Nitrokey/nitrokey-3c-nfc-lpc55-hardware/production-data/nk3cn424-zeus-assembled.png

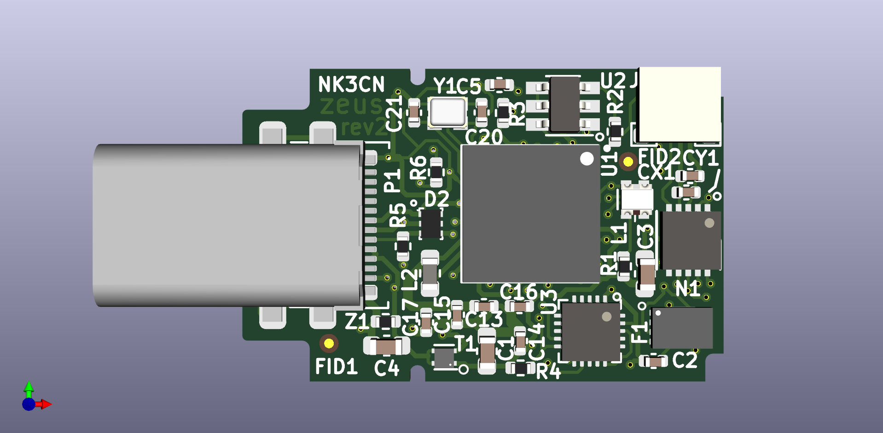
production-data/nk3cn424-zeus-assembled.png
