Nitrokey/nitrokey-3c-nfc-lpc55-hardware/production-data/USB_plug_pins.png

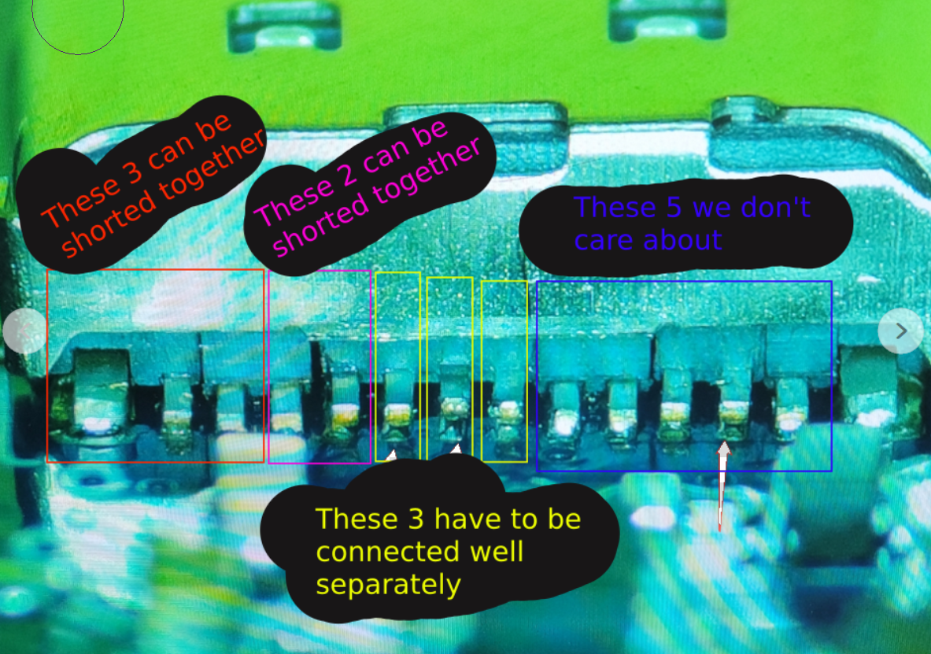
production-data/USB_plug_pins.png
