Nitrokey/nitrokey-3c-nfc-lpc55-hardware/README.md

# Nitrokey 3C NFC Hardware

The hardware files of [Nitrokey 3C NFC](https://shop.nitrokey.com/shop/nk3cn-nitrokey-3c-nfc-148).
The firmware is [here](https://github.com/Nitrokey/nitrokey-3-firmware).
