Nitrokey/nitrokey-3c-nfc-lpc55-hardware/nk3cn-zeus.step

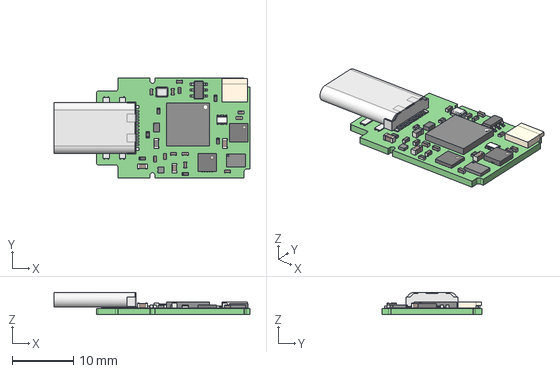
[picture p3: CAD file, 2026-04-24]
nk3cn-zeus.step
31.9 x 16.2 x 3.60 mm
