Nitrokey/nitrokey-3c-nfc-lpc55-hardware/nk3cn-zeus.pdf

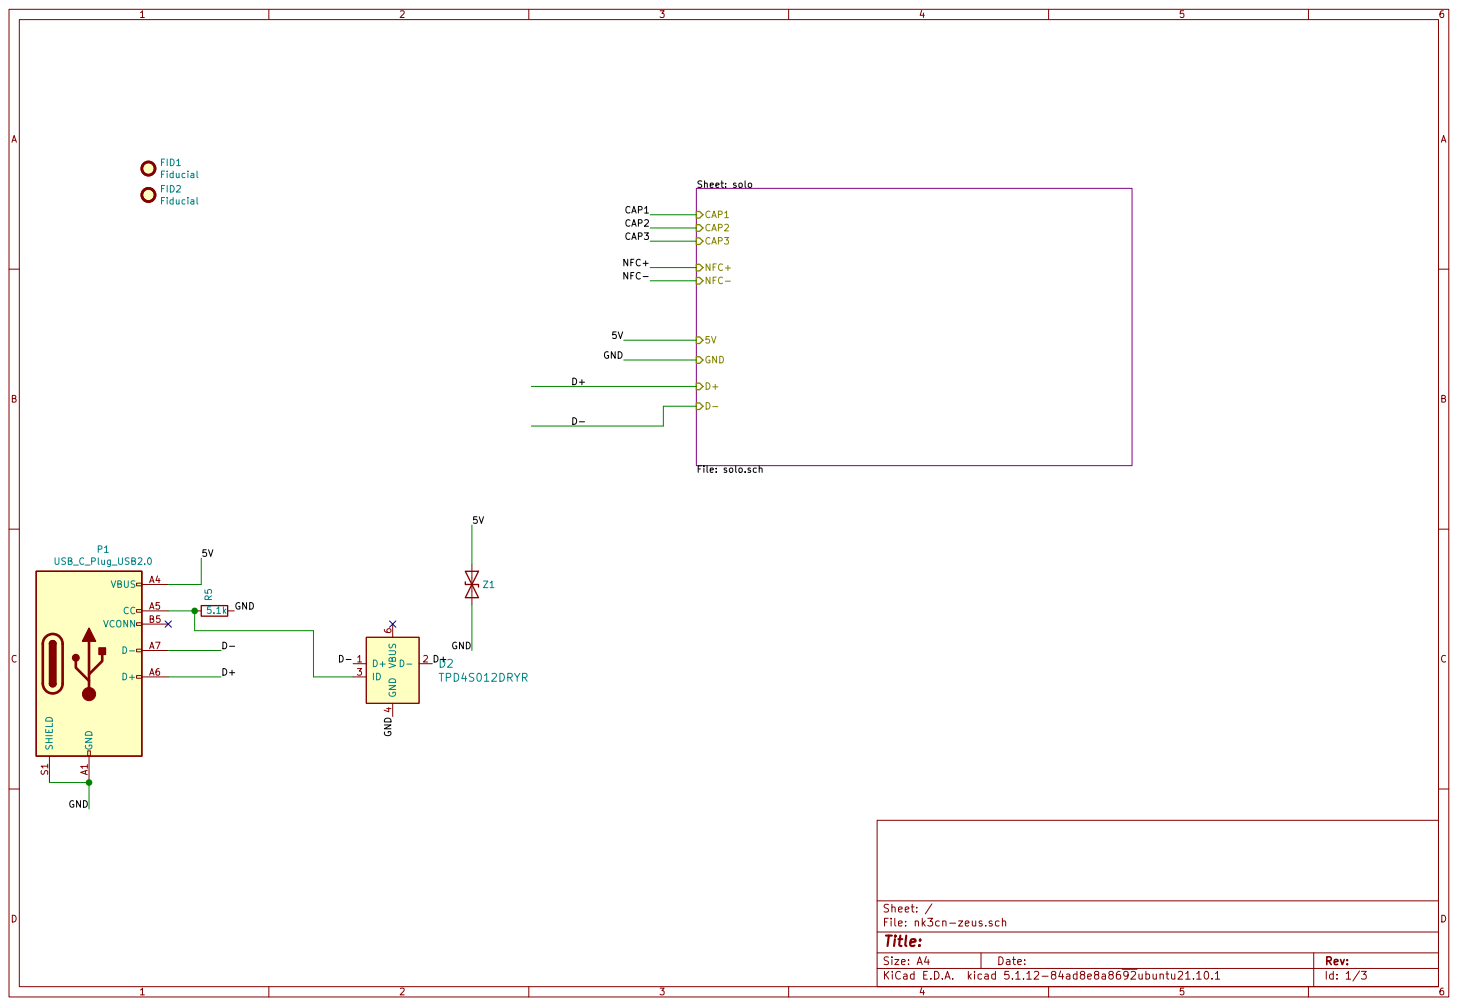
[picture p4: page 1]

Sheet: solo File: solo.sch
CAP1 CAP2 CAP3 NFC+

Id: 1/3 Title: File: nk3cn-zeus.sch Sheet: /

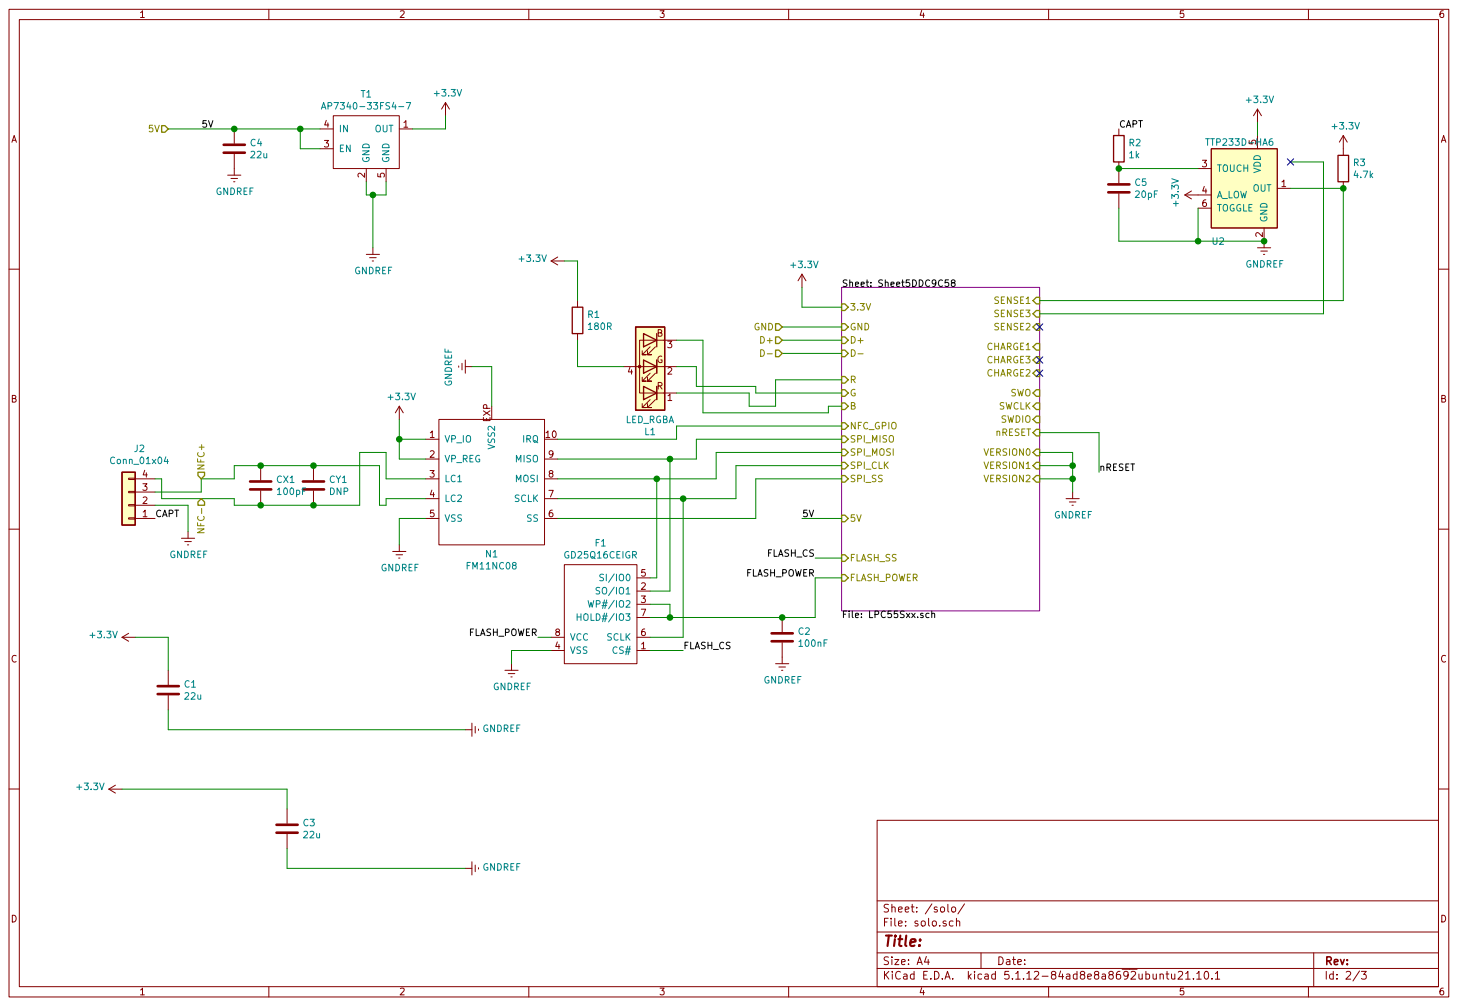
[picture p5: page 2]

Id: 2/3 Title: File: solo.sch Sheet: /solo/

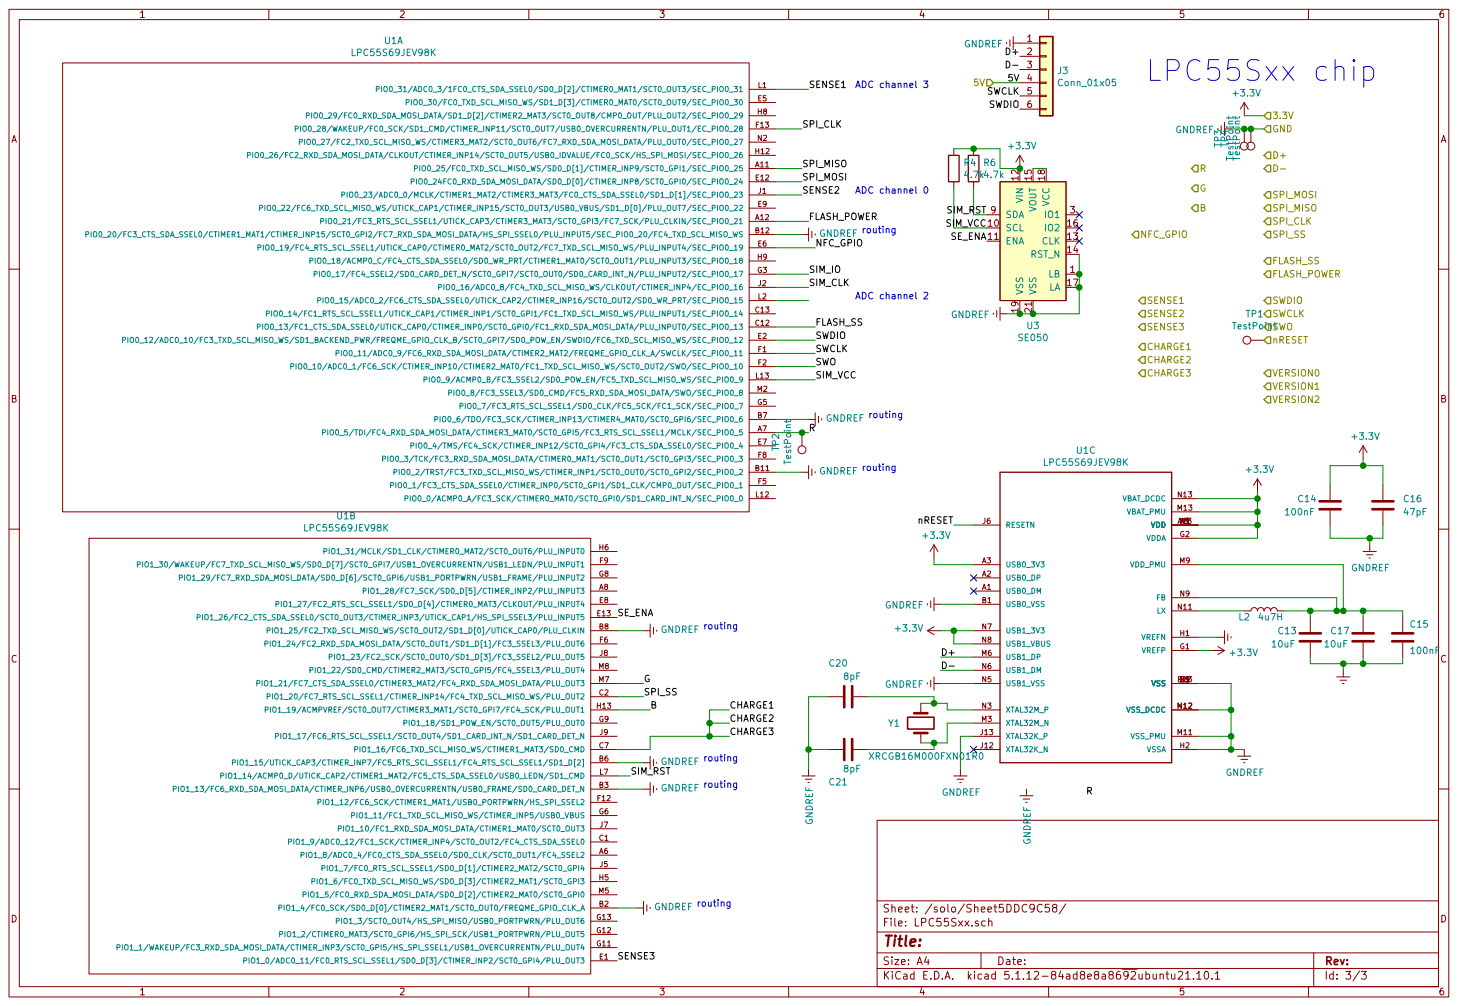
[picture p6: page 3]

ADC channel 0 ADC channel 3

Id: 3/3 Title: File: LPC55Sxx.sch Sheet: /solo/Sheet5DDC9C58/
