Nitrokey/nitrokey-3c-nfc-lpc55-hardware/nk3cn-zeus.kicad_pcb

## KiCad design nk3cn-zeus.kicad_pcb (2026-04-24)

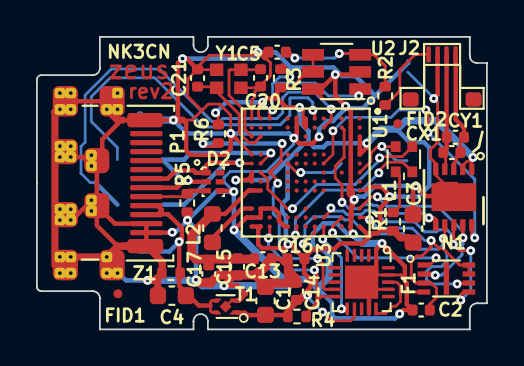
[picture p7: board nk3cn-zeus.kicad_pcb from above]

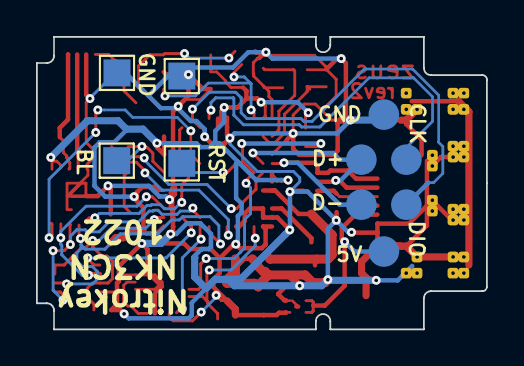
[picture p8: board nk3cn-zeus.kicad_pcb from below]

Board: 2 copper layers, 25.0 x 16.2 mm, 40 parts (5 on the bottom side), 33 nets.

Parts:
C1, C3, C4: 22u; C_0603_1608Metric
C2, C14, C15: 100nF; C_0402_1005Metric
C5: 20pF; C_0402_1005Metric
C13, C17: 10uF; C_0402_1005Metric
C16: 47pF; C_0402_1005Metric
C20, C21: 8pF; C_0402_1005Metric
CX1: 100pF; C_0402_1005Metric
CY1: DNP; C_0402_1005Metric
D2: TPD4S012DRYR; UFDFN-6_1.45x1mm
F1: GD25Q16CEIGR; FLASH_2x3_USON8
FID1, FID2: Fiducial; Fiducial_0.5mm_Mask1mm
J2: Conn_01x04; FPC_4_0.5-THD0509-04CL-GF
J3: Conn_01x05; nitro_programming_header
L1: LED_RGBA; RGB_LED_606
L2: 4u7H; L_0603_1608Metric
N1: FM11NC08; DFN-10-1EP_3x3mm_P0.5mm_EP1.55x2.48mm
P1: USB_C_Plug_USB2.0; UTC009-C-vias-optimized
R1: 180R; R_0402_1005Metric
R2: 1k; R_0402_1005Metric
R3, R4, R6: 4.7k; R_0402_1005Metric
R5: 5.1k; R_0402_1005Metric
T1: AP7340-33FS4-7; Diodes_X2-DFN1010_1x1mm_P0.65mm
TP1, TP2, TP3, TP4: TestPoint; TestPoint_Pad_1.5x1.5mm
U1: LPC55S69JEV98K; BGA98C50P13X13_700X700X97N
U2: TTP233D-HA6; TSOT-23-6
U3: SE050; UQFN-20-1EP_3x3mm_P0.4mm_EP1.85x1.85mm
Y1: XRCGB16M000FXN01R0; Crystal-2mmx1.6mm
Z1: GG040205100N2P; R_0402_1005Metric

Connections:
+3V3: C1.1, C3.1, C14.1, C16.1, N1.1, N1.2, R1.1, R3.1, R4.1, R6.1, T1.1, U1.A3, U1.A5, U1.A9, U1.A13, U1.G1, U1.G2, U1.M1, U1.M13, U1.N7, U1.N8, U1.N13, U2.4, U2.5, U3.12
/5V: C4.1, J3.4, P1.A4, P1.B9, T1.3, T1.4, Z1.1
/D+: D2.2, J3.2, P1.A6, U1.M6
/D-: D2.1, J3.3, P1.A7, U1.N6
/NFC+: CX1.1, CY1.1, J2.3, N1.4
/NFC-: CX1.2, CY1.2, J2.4, N1.3
/solo/CAPT: J2.1, R2.1
/solo/FLASH_CS: F1.1, U1.C12
/solo/FLASH_POWER: C2.1, F1.3, F1.7, F1.8, U1.A12
/solo/Sheet5DDC9C58/B: L1.3, U1.H13
/solo/Sheet5DDC9C58/G: L1.2, U1.M7
/solo/Sheet5DDC9C58/NFC_GPIO: N1.10, U1.E6
/solo/Sheet5DDC9C58/R: L1.1, TP2.1, U1.A7
/solo/Sheet5DDC9C58/SENSE1: R3.2, U1.L1, U2.1
/solo/Sheet5DDC9C58/SE_ENA: U1.E13, U3.11
/solo/Sheet5DDC9C58/SIM_RST: R6.2, U1.L7, U3.9
/solo/Sheet5DDC9C58/SIM_VCC: R4.2, U1.L13, U3.10
/solo/Sheet5DDC9C58/SPI_CLK: F1.6, N1.7, U1.F13
/solo/Sheet5DDC9C58/SPI_MISO: F1.2, N1.9, U1.A11
/solo/Sheet5DDC9C58/SPI_MOSI: F1.5, N1.8, U1.E12
/solo/Sheet5DDC9C58/SPI_SS: N1.6, U1.C2
/solo/Sheet5DDC9C58/SWCLK: J3.5, U1.F1
/solo/Sheet5DDC9C58/SWDIO: J3.6, U1.E2
/solo/nRESET: TP1.1, U1.J6
GNDREF: C1.2, C2.2, C3.2, C4.2, C5.2, C13.2, C14.2, C15.2, C16.2, C17.2, C20.1, C21.1, D2.4, F1.4, J2.2, J3.1, N1.5, N1.EXP, P1.A1, P1.B12, P1.S1, R5.2, T1.2, T1.5, TP3.1, TP4.1, U1.B1, U1.B2, U1.B3, U1.B5, U1.B6, U1.B7, U1.B8, U1.B9, U1.B11, U1.B12, U1.B13, U1.H1, U1.H2, U1.J13, U1.M11, U1.M12, U1.N1, U1.N5, U1.N12, U2.2, U2.6, U3.1, U3.14, U3.17, U3.19, U3.21, Y1.3, Z1.2
unnamed: C5.1, R2.2, U2.3
unnamed: C13.1, C15.1, C17.1, L2.2, U1.M9, U1.N9
unnamed: C20.2, U1.N3, Y1.1
unnamed: C21.2, U1.M3, Y1.2
unnamed: D2.3, P1.A5, R5.1
unnamed: L1.4, R1.2
unnamed: L2.1, U1.N11
unnamed: U3.15, U3.18
