Nitrokey/nitrokey-3c-nfc-lpc55-hardware/(threads)

Thread 1 (2022-12-21):

Add a cap to protect the USB-C connector?

jerabaul29, 2022-12-21:
Not sure if this is the right place to ask for the "feature" as this is not related to the PCB but to the "housing" part (feel free to move it), but I like reporting things on GH rather than other platforms.

I had a USB-C device "die" on me a couple of days ago due to dirt / sand getting in the connector and damaging it. To avoid this happening with the Nitrokey-C, could you provide a "USB-C cap / dust cover" with the Nitrokey? Something similar to for example:

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

or

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

they cost literally a tenth of a dollar when bying in bulk (though maybe having a nice quality one could be a tiny bit more expensive), and this is the kind of small addition that will have a lot to say on average for how long NK-3 will last :) .

jerabaul29, 2023-08-05:
I just ordered a male cap like this:

https://www.delock.com/produkt/64008/merkmale.html?g=1202

Buying small samples is a bit expensive, but I guess that you would be able to get a good price if buying in large volumes. I will let you know how I feel about the cap.

Otherwise a custom cap coming with the NK3 (as was the case for the NK2 Pros I received from you) would be great.
